IvanIkra/tablo-t75/cad/preview/back.png

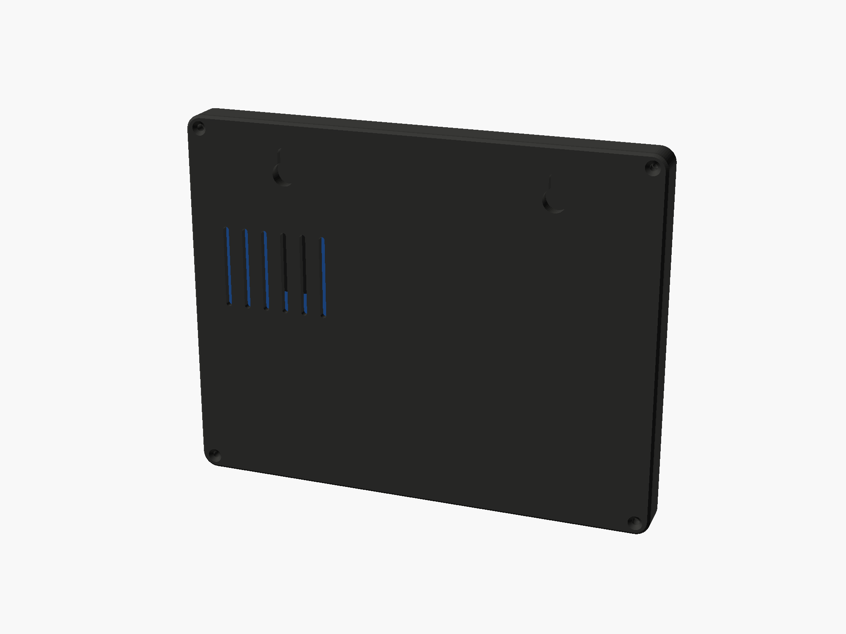
cad/preview/back.png
