IvanIkra/tablo-t75/cad/preview/corner.png

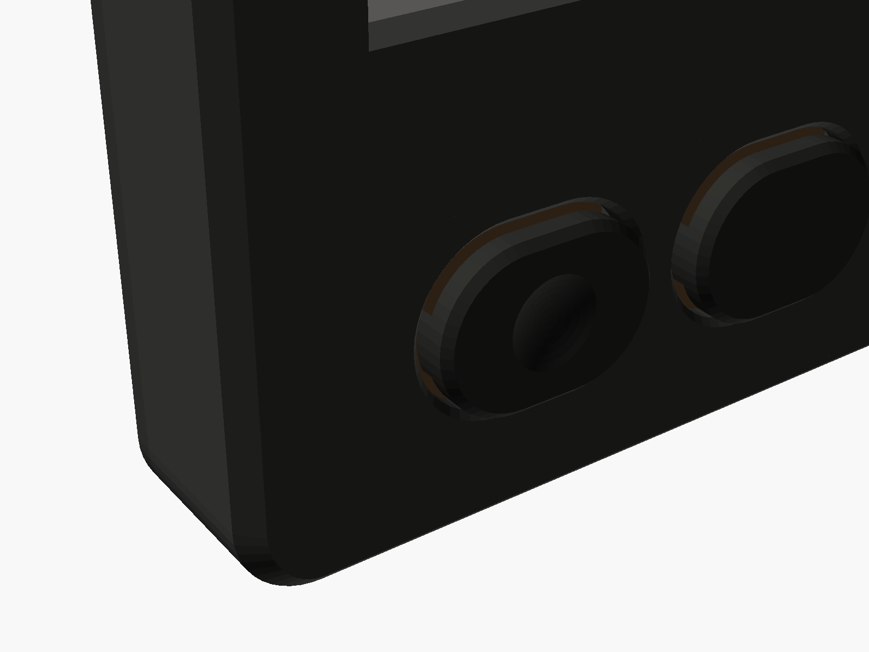
cad/preview/corner.png
