IvanIkra/tablo-t75/cad/preview/desk.png

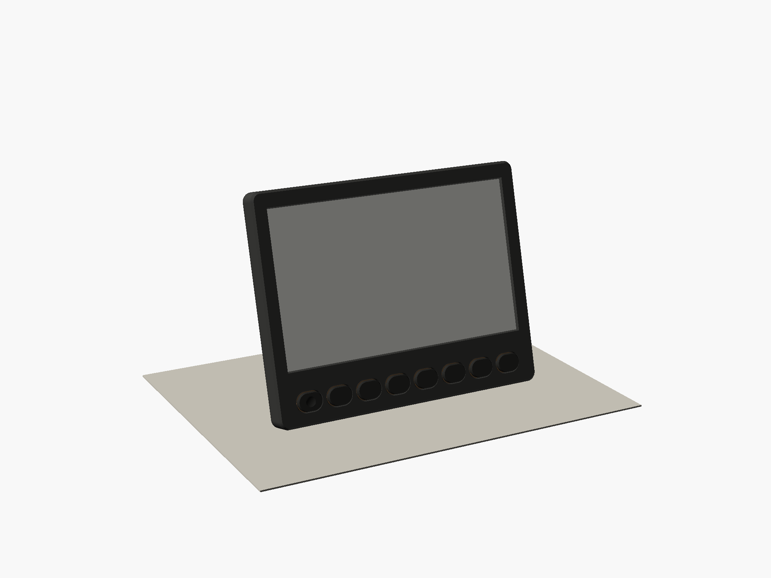
cad/preview/desk.png
