IvanIkra/tablo-t75/cad/preview/desk_back.png

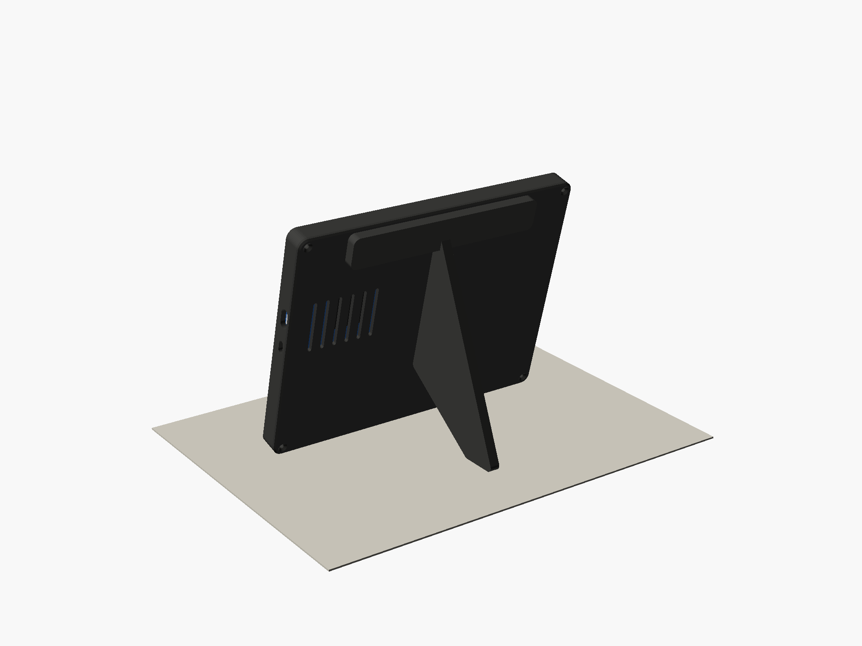
cad/preview/desk_back.png
