IvanIkra/tablo-t75/cad/preview/desk_side.png

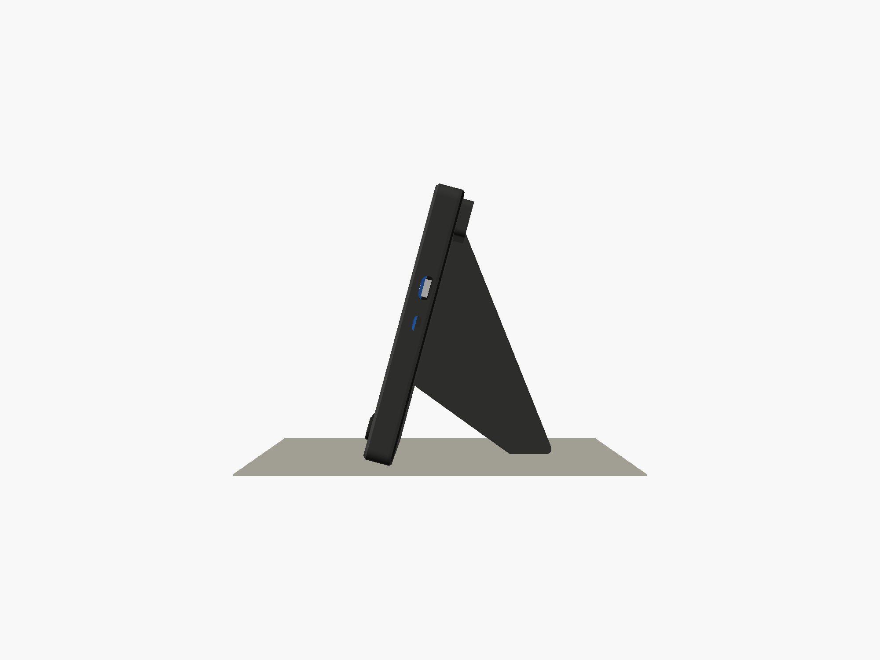
cad/preview/desk_side.png
