IvanIkra/tablo-t75/cad/preview/exploded.png

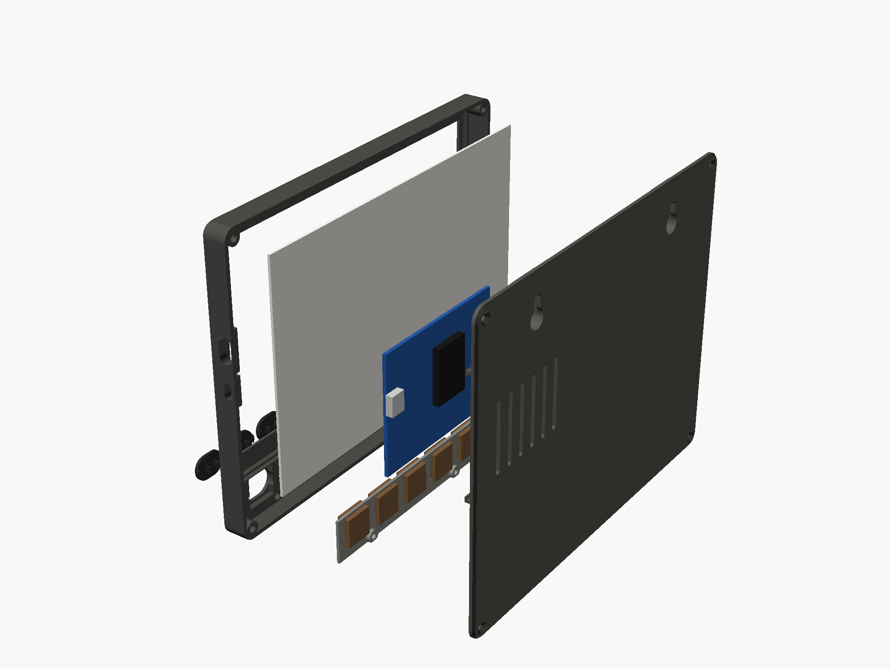
cad/preview/exploded.png
