IvanIkra/tablo-t75/cad/preview/inside.png

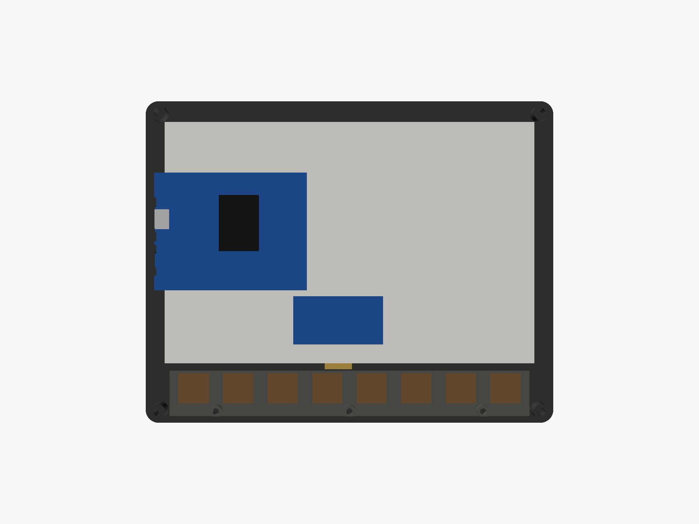
cad/preview/inside.png
