IvanIkra/tablo-t75/cad/preview/leg.png

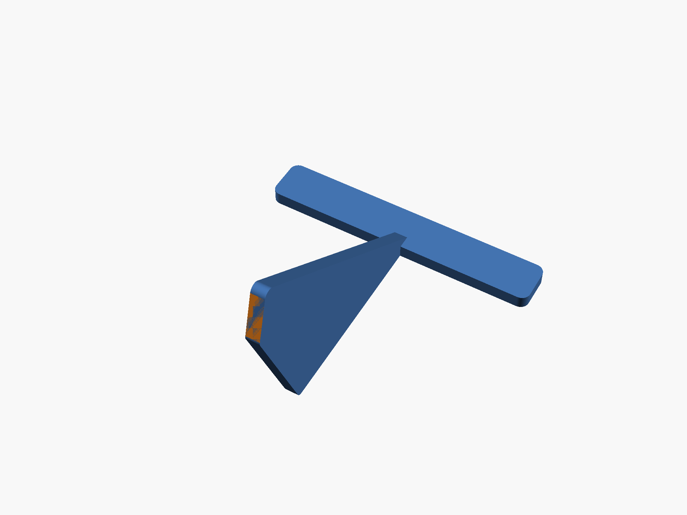
cad/preview/leg.png
