IvanIkra/tablo-t75/cad/preview/ports.png

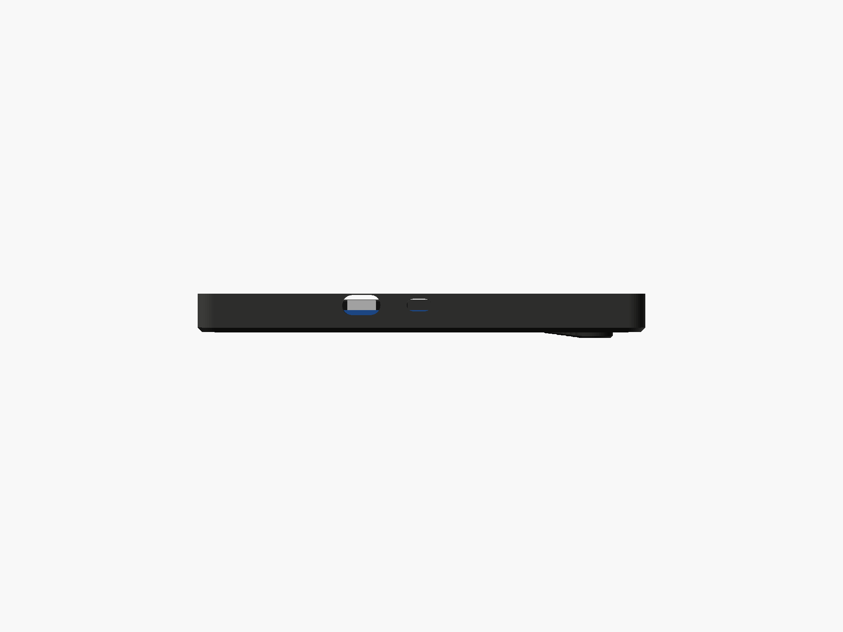
cad/preview/ports.png
