IvanIkra/tablo-t75/cad/preview/wall.png

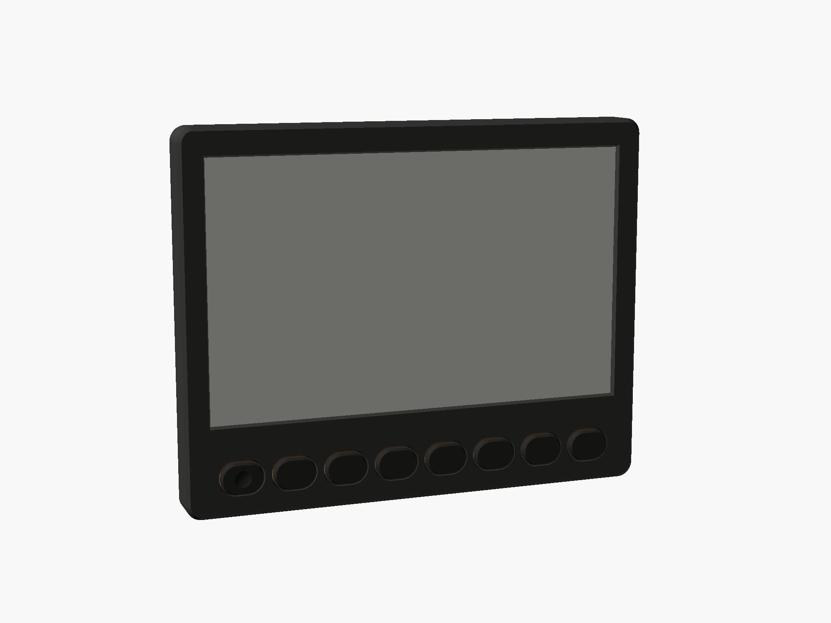
cad/preview/wall.png
