IvanIkra/tablo-t75/cad/preview/wall_mount.png

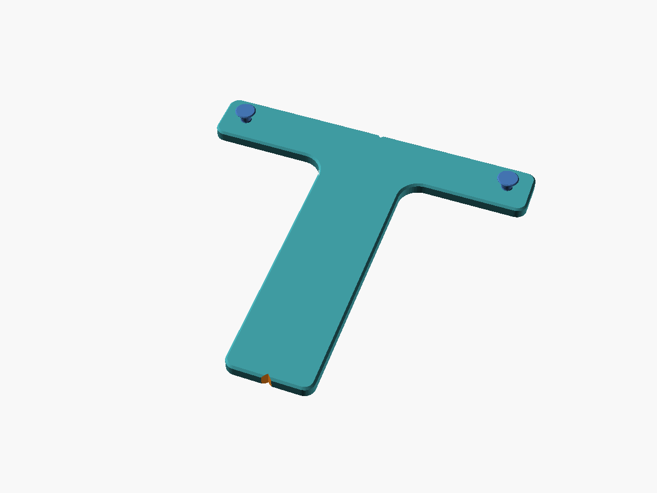
cad/preview/wall_mount.png
