IvanIkra/tablo-t75/cad/preview/wall_mount_back.png

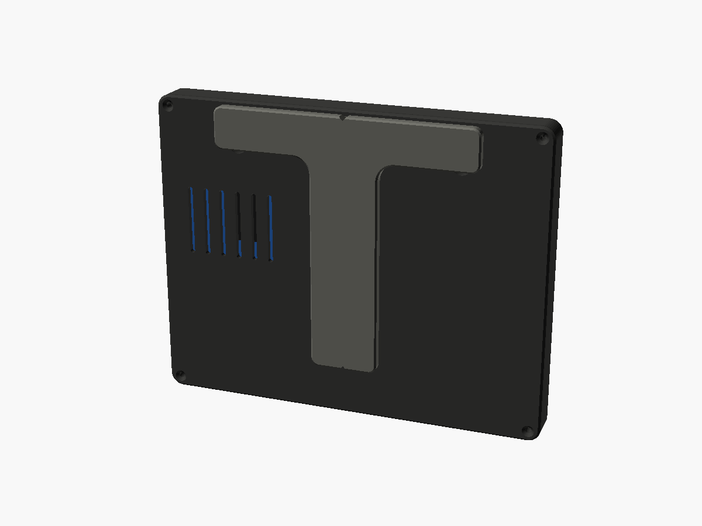
cad/preview/wall_mount_back.png
