IvanIkra/tablo-t75/docs/images/social-preview.png

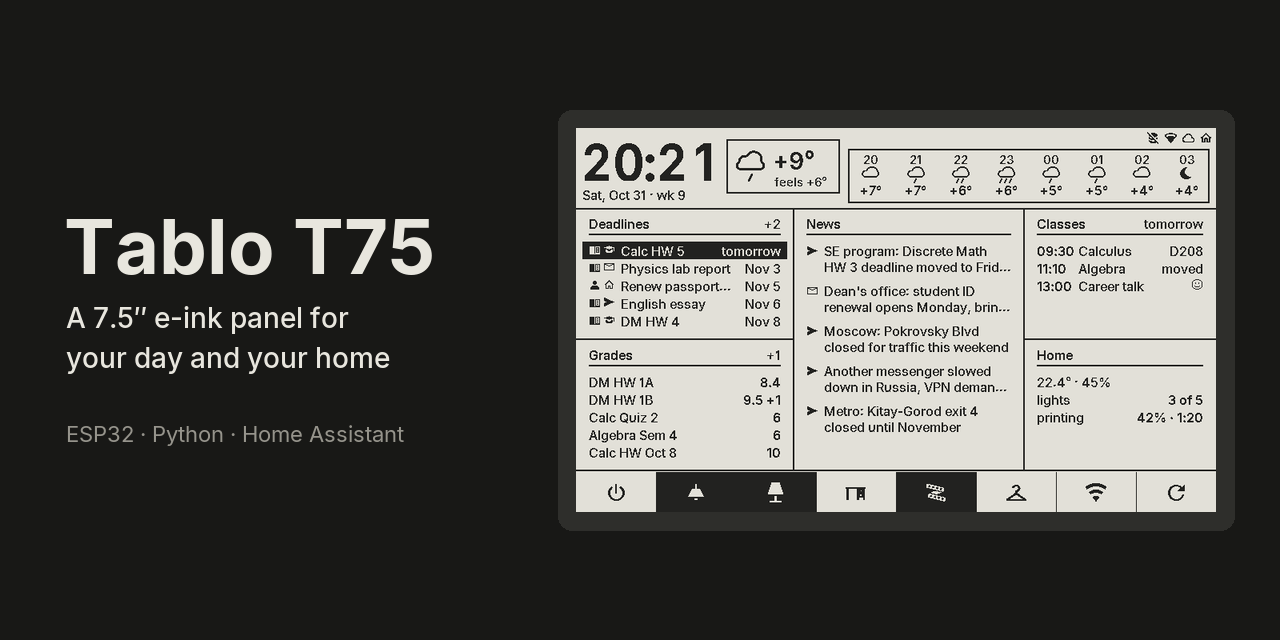
docs/images/social-preview.png
