IvanIkra/tablo-t75/presentation/r3/tablo-back-en.png

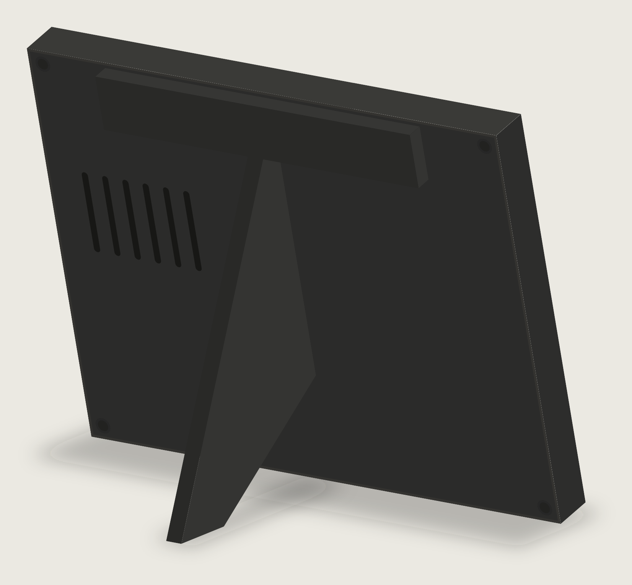
presentation/r3/tablo-back-en.png
