IvanIkra/tablo-t75/presentation/r3/tablo-body-en.png

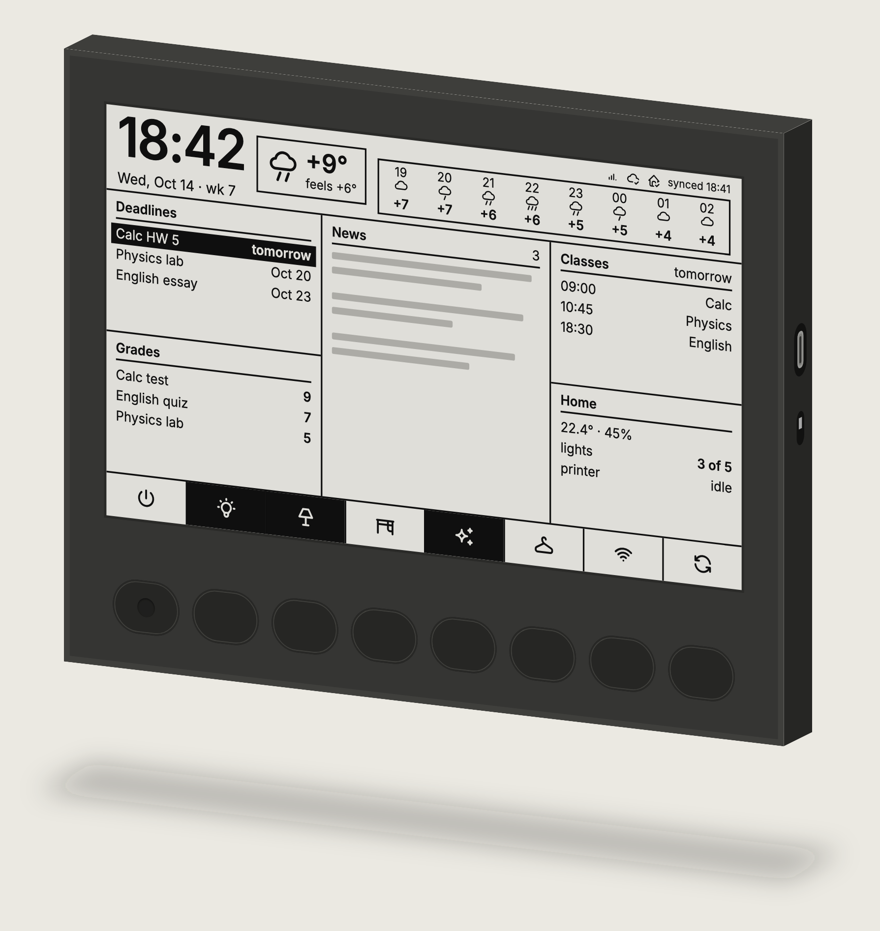
presentation/r3/tablo-body-en.png
