IvanIkra/tablo-t75/presentation/r3/tablo-sheet-en.png

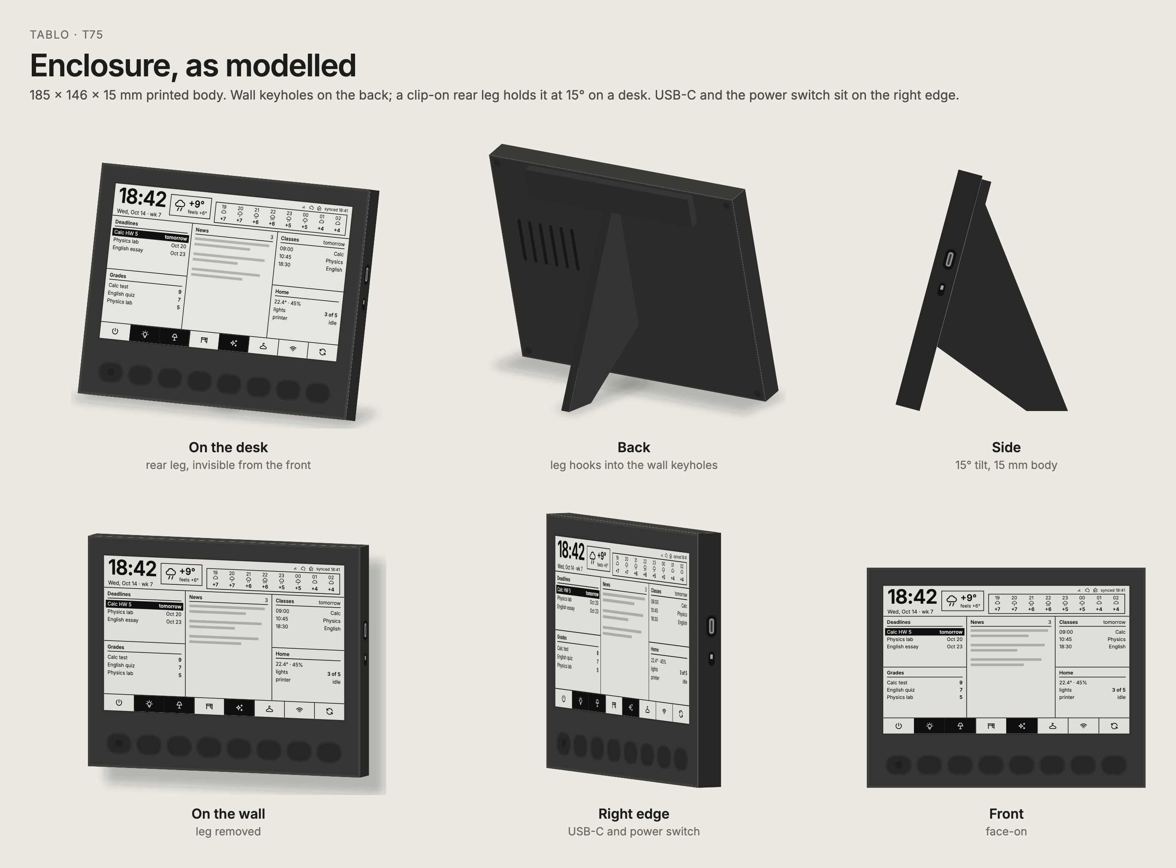
presentation/r3/tablo-sheet-en.png
