IvanIkra/tablo-t75/presentation/r3/tablo-wall-en.png

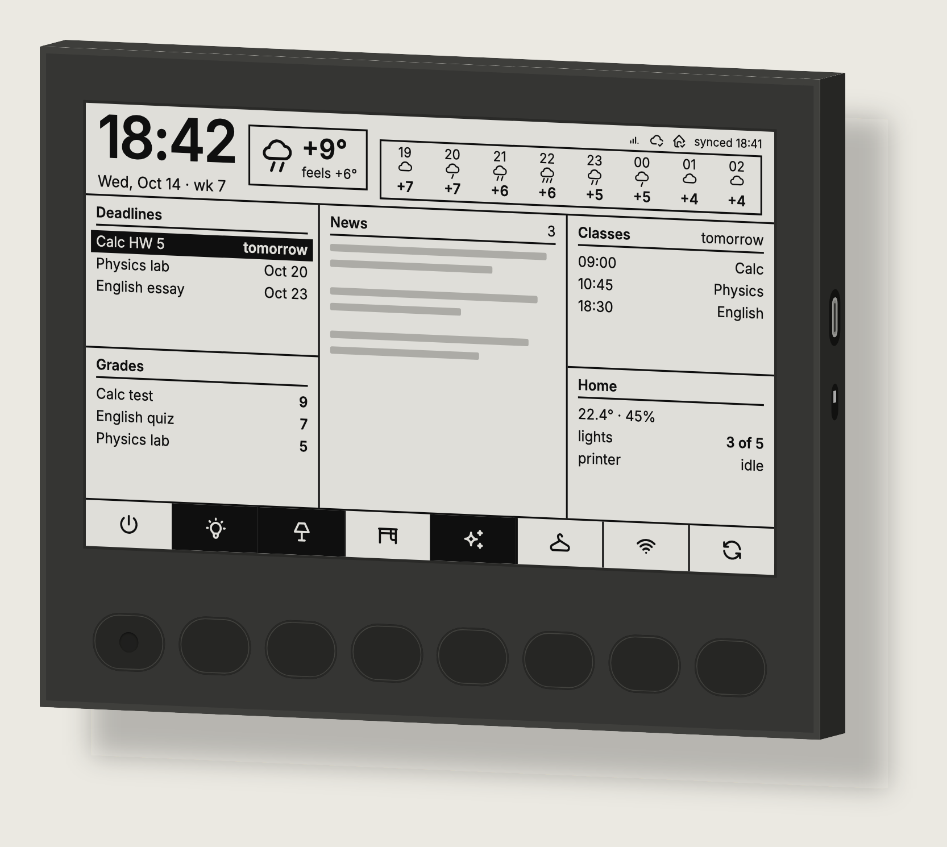
presentation/r3/tablo-wall-en.png
