IvanIkra/tablo-t75/pcb/bom-parts.csv

Value | Footprint | Fit | Manufacturer | MPN | Description | Notes
10u | Capacitor_SMD:C_0805_2012Metric | yes | Samsung | CL21A106KAYNNNE | Ceramic capacitor 10 uF 25 V X5R 0805 | any 10 uF ≥16 V X5R/X7R 0805
100n | Capacitor_SMD:C_0402_1005Metric | yes | Samsung | CL05B104KO5NNNC | Ceramic capacitor 100 nF 16 V X7R 0402 | any equivalent
22u | Capacitor_SMD:C_0805_2012Metric | yes | Samsung | CL21A226MQQNNNE | Ceramic capacitor 22 uF 6.3 V X5R 0805 | any 22 uF ≥6.3 V X5R 0805
1u | Capacitor_SMD:C_0603_1608Metric | yes | Samsung | CL10A105KB8NNNC | Ceramic capacitor 1 uF 50 V X5R 0603 | any 1 uF ≥16 V 0603
12p | Capacitor_SMD:C_0402_1005Metric | yes | Murata | GRM1555C1H120JA01D | Ceramic capacitor 12 pF 50 V C0G 0402 | C0G/NP0 only
4.7u 25V | Capacitor_SMD:C_0805_2012Metric | yes | Samsung | CL21A475KAQNNNE | Ceramic capacitor 4.7 uF 25 V X5R 0805 | ≥25 V rating required (e-paper booster)
1u 25V | Capacitor_SMD:C_0603_1608Metric | yes | Samsung | CL10A105KB8NNNC | Ceramic capacitor 1 uF 50 V X5R 0603 | ≥25 V rating required
MBR0530 | Diode_SMD:D_SOD-123 | yes | onsemi | MBR0530T1G | Schottky diode 30 V 0.5 A SOD-123
USB-C | Connector_USB:USB_C_Receptacle_HRO_TYPE-C-31-M-12 | yes | Korean Hroparts | TYPE-C-31-M-12 | USB Type-C receptacle 16 pin, SMD with through-hole shell pegs
LiPo 604060 | Connector_Wire:SolderWire-0.25sqmm_1x02_P4.2mm_D0.65mm_OD1.7mm | no |  |  | Battery lead pads | do not fit: the battery leads are soldered by hand
GDEY075T7 FPC | Connector_FFC-FPC:Hirose_FH12-24S-0.5SH_1x24-1MP_P0.50mm_Horizontal | yes | Hirose | FH12A-24S-0.5SH(55) | FPC connector 24 pin 0.5 mm, horizontal, TOP contact, flip lock | top contact is required: the screen FPC reaches the connector with its contacts facing up; same land pattern as FH12 (Hirose catalog)
0.47u | Inductor_SMD:L_Taiyo-Yuden_NR-40xx | yes | Coilcraft | XFL4015-471MEC | Power inductor 0.47 uH, Isat ≥ 4 A, 4 x 4 mm | TPS63802 datasheet choice (Isat 5.4 A at 20 % drop); its terminals sit inside the 4 x 4 mm land on the board
10u 1A | Inductor_SMD:L_Taiyo-Yuden_NR-40xx | yes | Sunlord | SWPA4018S100MT | Power inductor 10 uH, Isat 1.3 A, Irms 0.84 A, 4 x 4 x 1.8 mm | land 1.1 x 3.7 mm pads, 1.9 mm gap: fits the NR-40xx land; Taiyo Yuden NR4018T100M is the same but not for new designs
Si1308EDL | Package_TO_SOT_SMD:SOT-323_SC-70 | yes | Vishay | Si1308EDL-T1-GE3 | N-channel MOSFET 30 V SC-70
5.1k | Resistor_SMD:R_0402_1005Metric | yes | Yageo | RC0402FR-075K1L | Resistor 5.1 kOhm 1% 0402
1.0k | Resistor_SMD:R_0402_1005Metric | yes | Yageo | RC0402FR-071KL | Resistor 1 kOhm 1% 0402 | sets the charge current
1.1k | Resistor_SMD:R_0402_1005Metric | yes | Yageo | RC0402FR-071K1L | Resistor 1.1 kOhm 1% 0402 | sets the input current limit
10k | Resistor_SMD:R_0402_1005Metric | yes | Yageo | RC0402FR-0710KL | Resistor 10 kOhm 1% 0402
100k | Resistor_SMD:R_0402_1005Metric | yes | Yageo | RC0402FR-07100KL | Resistor 100 kOhm 1% 0402
4.7k | Resistor_SMD:R_0402_1005Metric | yes | Yageo | RC0402FR-074K7L | Resistor 4.7 kOhm 1% 0402
511k | Resistor_SMD:R_0402_1005Metric | yes | Yageo | RC0402FR-07511KL | Resistor 511 kOhm 1% 0402 | regulator feedback: 1% required
91k | Resistor_SMD:R_0402_1005Metric | yes | Yageo | RC0402FR-0791KL | Resistor 91 kOhm 1% 0402 | regulator feedback: 1% required
1M | Resistor_SMD:R_0402_1005Metric | yes | Yageo | RC0402FR-071ML | Resistor 1 MOhm 1% 0402
0.47 | Resistor_SMD:R_0603_1608Metric | yes | Yageo | RL0603FR-070R47L | Current sense resistor 0.47 Ohm 1% 0603
Choc K1 | tablo:Kailh_Choc_V1 | no | Kailh | CPG1350 | Kailh Choc v1 low-profile switch | do not fit: soldered by hand after the switches are clipped into the enclosure plate
Choc K2 | tablo:Kailh_Choc_V1 | no | Kailh | CPG1350 | Kailh Choc v1 low-profile switch | do not fit: soldered by hand after the switches are clipped into the enclosure plate
Choc K3 | tablo:Kailh_Choc_V1 | no | Kailh | CPG1350 | Kailh Choc v1 low-profile switch | do not fit: soldered by hand after the switches are clipped into the enclosure plate
Choc K4 | tablo:Kailh_Choc_V1 | no | Kailh | CPG1350 | Kailh Choc v1 low-profile switch | do not fit: soldered by hand after the switches are clipped into the enclosure plate
Choc K5 | tablo:Kailh_Choc_V1 | no | Kailh | CPG1350 | Kailh Choc v1 low-profile switch | do not fit: soldered by hand after the switches are clipped into the enclosure plate
Choc K6 | tablo:Kailh_Choc_V1 | no | Kailh | CPG1350 | Kailh Choc v1 low-profile switch | do not fit: soldered by hand after the switches are clipped into the enclosure plate
Choc K7 | tablo:Kailh_Choc_V1 | no | Kailh | CPG1350 | Kailh Choc v1 low-profile switch | do not fit: soldered by hand after the switches are clipped into the enclosure plate
Choc K8 | tablo:Kailh_Choc_V1 | no | Kailh | CPG1350 | Kailh Choc v1 low-profile switch | do not fit: soldered by hand after the switches are clipped into the enclosure plate
RESET | Button_Switch_SMD:SW_Push_1P1T_XKB_TS-1187A | yes | XKB Connection | TS-1187A-B-A-B | Tactile switch SMD 5.1 x 5.1 mm
BOOT | Button_Switch_SMD:SW_Push_1P1T_XKB_TS-1187A | yes | XKB Connection | TS-1187A-B-A-B | Tactile switch SMD 5.1 x 5.1 mm
Power | Button_Switch_SMD:SW_SPDT_PCM12 | yes | C&K | PCM12SMTR | Slide switch SPDT SMD, right angle
+3V3 | TestPoint:TestPoint_Pad_D1.0mm | no |  |  | Test pad | copper only
GND | TestPoint:TestPoint_Pad_D1.0mm | no |  |  | Test pad | copper only
VBAT | TestPoint:TestPoint_Pad_D1.0mm | no |  |  | Test pad | copper only
VSYS | TestPoint:TestPoint_Pad_D1.0mm | no |  |  | Test pad | copper only
UART_TX | TestPoint:TestPoint_Pad_D1.0mm | no |  |  | Test pad | copper only
UART_RX | TestPoint:TestPoint_Pad_D1.0mm | no |  |  | Test pad | copper only
ESP32-S3-WROOM-1U-N16R8 | RF_Module:ESP32-S3-WROOM-1U | yes | Espressif | ESP32-S3-WROOM-1U-N16R8 | Wi-Fi/BLE module, 16 MB flash, 8 MB PSRAM, U.FL antenna connector
BQ24074RGT | Package_DFN_QFN:VQFN-16-1EP_3x3mm_P0.5mm_EP1.6x1.6mm | yes | Texas Instruments | BQ24074RGTR | Li-ion charger with power path, VQFN-16 3 x 3 mm | exposed pad must be soldered
MAX17048G+T10 | Package_DFN_QFN:TDFN-8-1EP_2x2mm_P0.5mm_EP0.8x1.2mm | yes | Analog Devices | MAX17048G+T10 | Li-ion fuel gauge, TDFN-8 2 x 2 mm | exposed pad must be soldered
TPS63802DLAR | tablo:Texas_DLA0010A_VSON-HR-10_2x3mm | yes | Texas Instruments | TPS63802DLAR | Buck-boost converter 3.3 V, VSON-HR-10 2 x 3 mm | land pattern from the datasheet (DLA0010A)
TPS22917DBV | Package_TO_SOT_SMD:SOT-23-6 | yes | Texas Instruments | TPS22917DBVR | Load switch 2 A, SOT-23-6
USBLC6-2SC6 | Package_TO_SOT_SMD:SOT-23-6 | yes | STMicroelectronics | USBLC6-2SC6 | USB ESD protection, SOT-23-6
32.768k | Crystal:Crystal_SMD_3215-2Pin_3.2x1.5mm | yes | Epson | Q13FC13500003 | Crystal FC-135 32.768 kHz, 9 pF load, ±20 ppm, 3.2 x 1.5 mm | 9 pF load matches the 12 pF caps on each side
