IvanIkra/tablo-t75/cad/stl/custom/tablo-wall_mount.stl

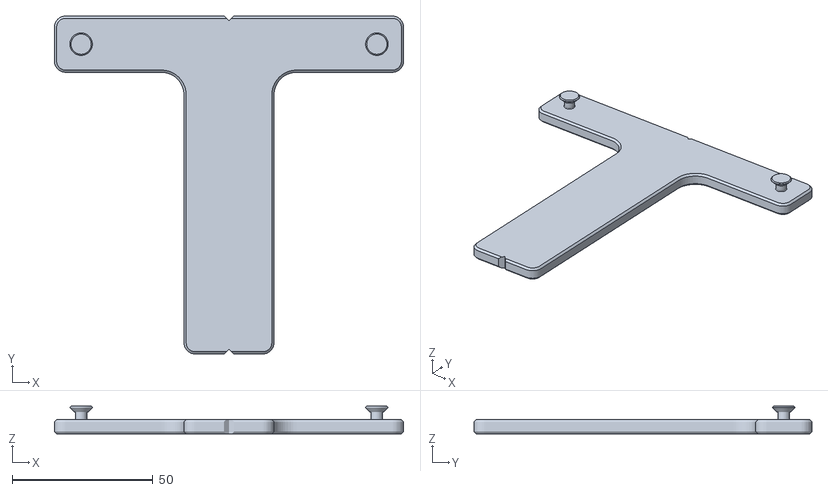
[picture p42: CAD file, 2026-11-09]
cad/stl/custom/tablo-wall_mount.stl
124.0 x 120.0 x 9.79
