IvanIkra/tablo-t75/cad/stl/custom/tablo-front.stl

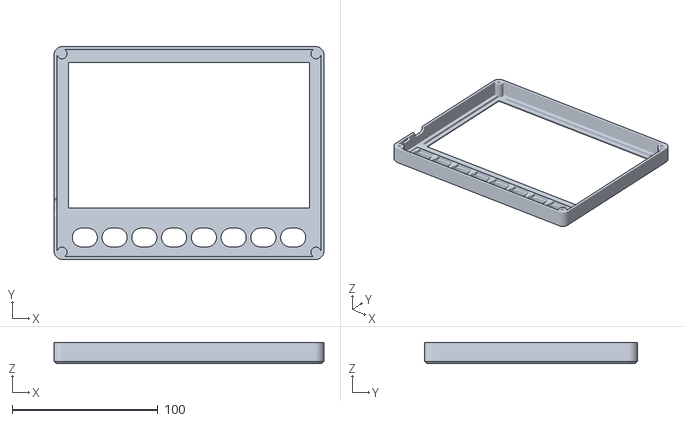
[picture p43: CAD file, 2026-11-09]
cad/stl/custom/tablo-front.stl
185.0 x 146.0 x 14.5
