IvanIkra/tablo-t75/cad/stl/esp32l/tablo-peg.stl

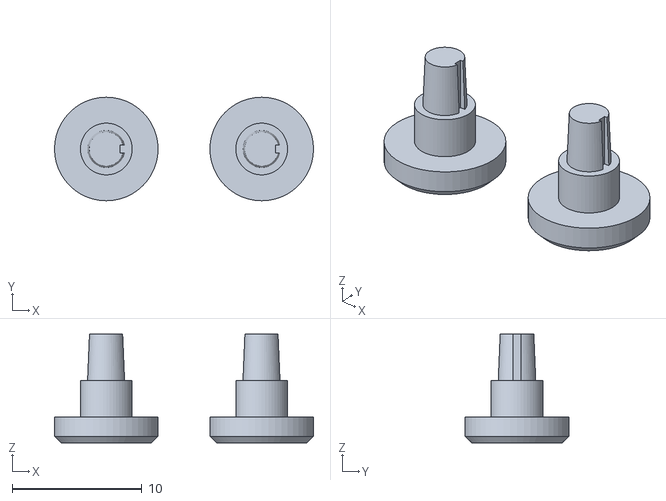
[picture p44: CAD file, 2026-10-31]
cad/stl/esp32l/tablo-peg.stl
20.0 x 8.00 x 8.39
