IvanIkra/tablo-t75/cad/stl/custom/tablo-key_test.stl

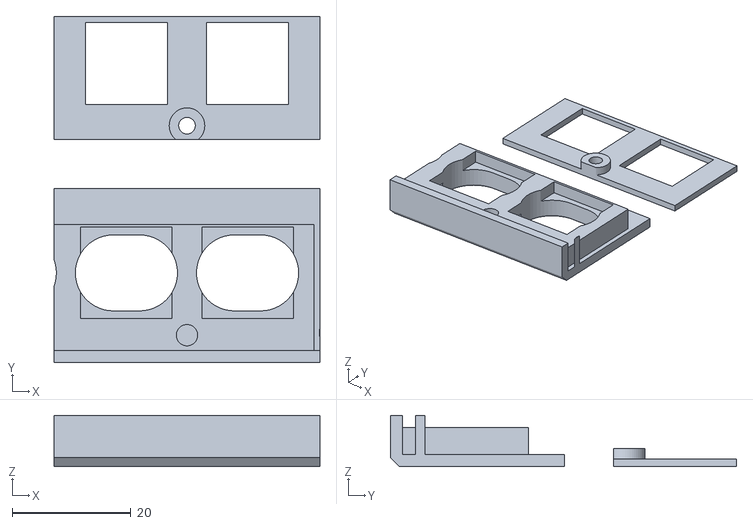
[picture p45: CAD file, 2026-11-09]
cad/stl/custom/tablo-key_test.stl
44.8 x 58.3 x 8.60
