IvanIkra/tablo-t75/cad/stl/esp32l/tablo-back.stl

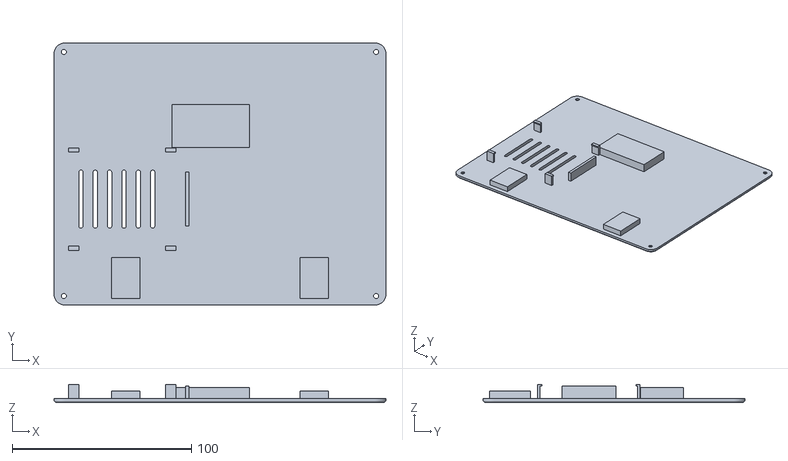
[picture p46: CAD file, 2026-10-30]
cad/stl/esp32l/tablo-back.stl
185.0 x 146.0 x 10.3
