IvanIkra/tablo-t75/cad/stl/custom/tablo-back.stl

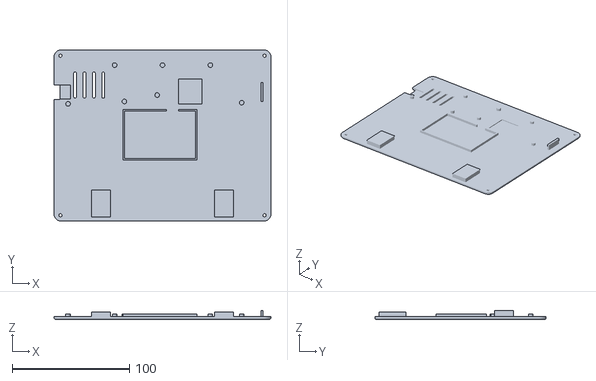
[picture p47: CAD file, 2026-11-09]
cad/stl/custom/tablo-back.stl
185.0 x 146.0 x 7.90
