IvanIkra/tablo-t75/cad/stl/custom/tablo-leg.stl

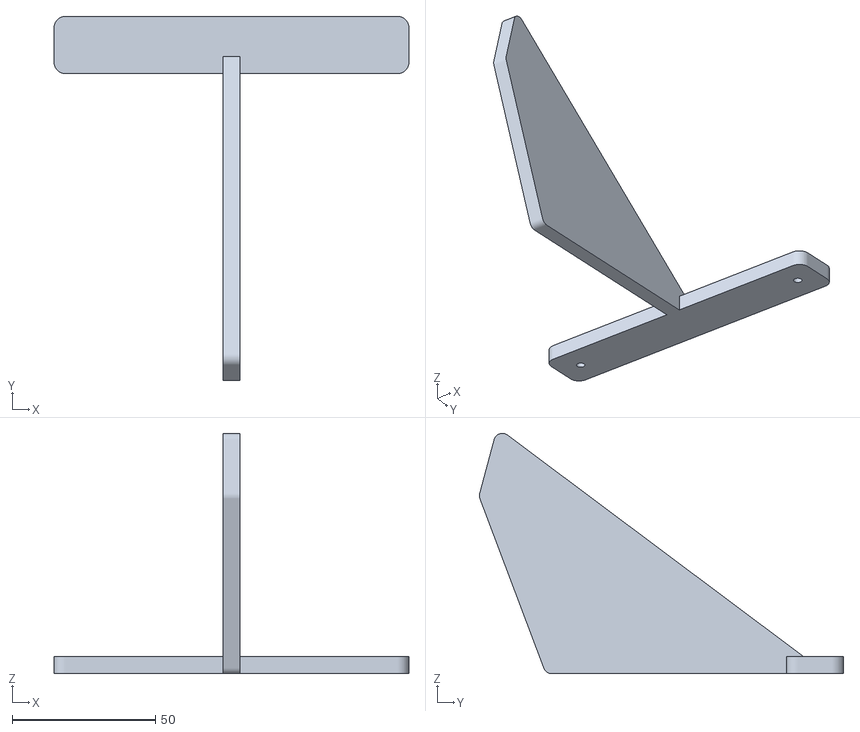
[picture p48: CAD file, 2026-10-17]
cad/stl/custom/tablo-leg.stl
124.0 x 127.2 x 83.9
