IvanIkra/tablo-t75/cad/stl/esp32l/tablo-keycap_dimple.stl

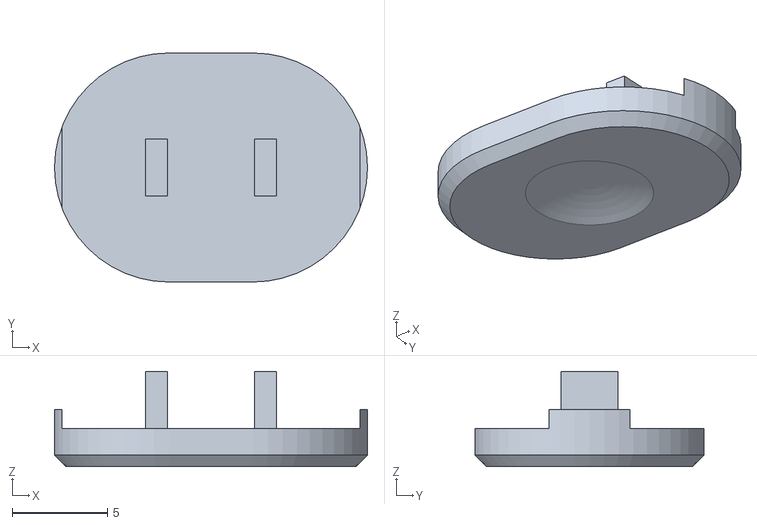
[picture p49: CAD file, 2026-10-17]
cad/stl/esp32l/tablo-keycap_dimple.stl
16.4 x 12.0 x 4.99
