IvanIkra/tablo-t75/cad/stl/custom/tablo-keycap.stl

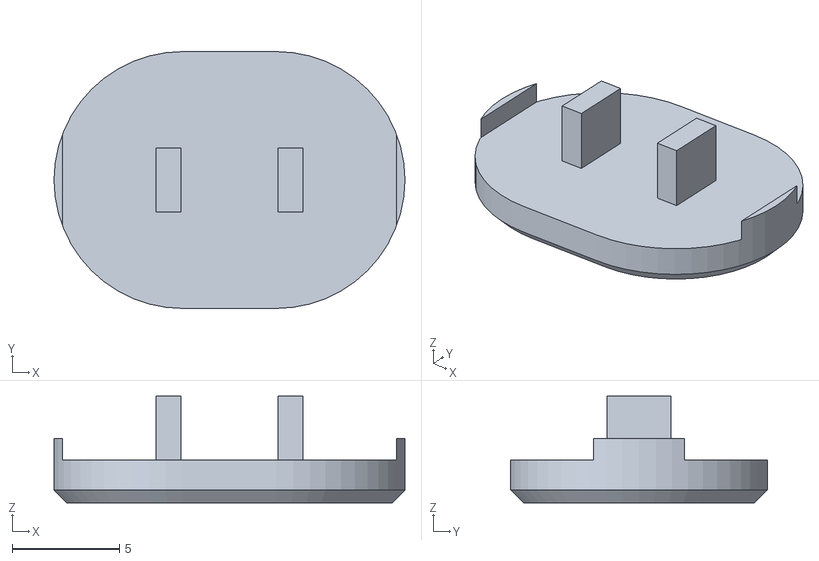
[picture p50: CAD file, 2026-10-17]
cad/stl/custom/tablo-keycap.stl
16.4 x 12.0 x 4.99
