IvanIkra/tablo-t75/cad/stl/esp32l/tablo-key_plate.stl

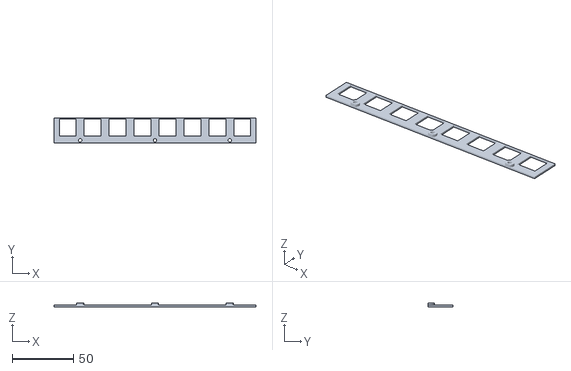
[picture p51: CAD file, 2026-10-17]
cad/stl/esp32l/tablo-key_plate.stl
165.2 x 20.7 x 3.00
