IvanIkra/tablo-t75/(list of files, cad)

Other CAD files:
cad/stl/esp32l/tablo-wall_mount.stl
cad/stl/esp32l/tablo-front.stl
cad/stl/esp32l/tablo-key_test.stl
