IvanIkra/tablo-t75/cad/preview/key_test.png

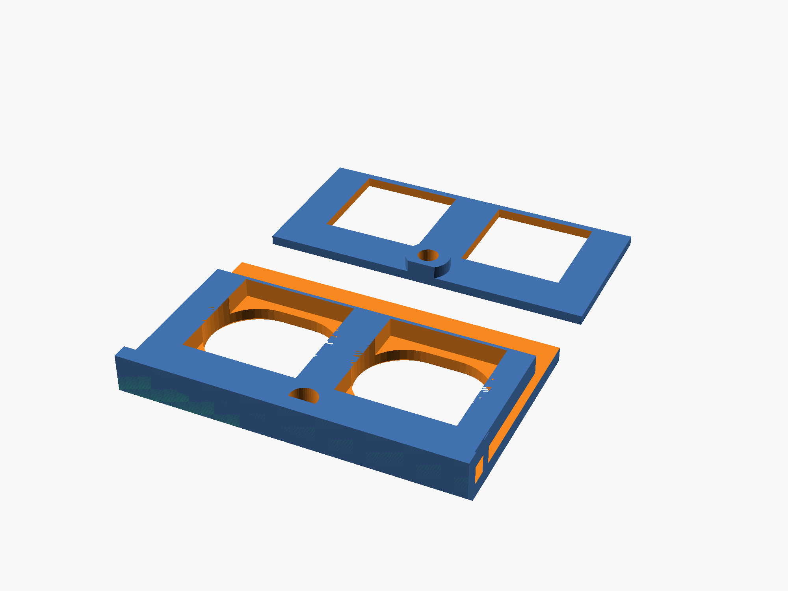
cad/preview/key_test.png
