IvanIkra/tablo-t75/pcb/tablo.kicad_pcb

## KiCad design pcb/tablo.kicad_pcb (2026-11-09)

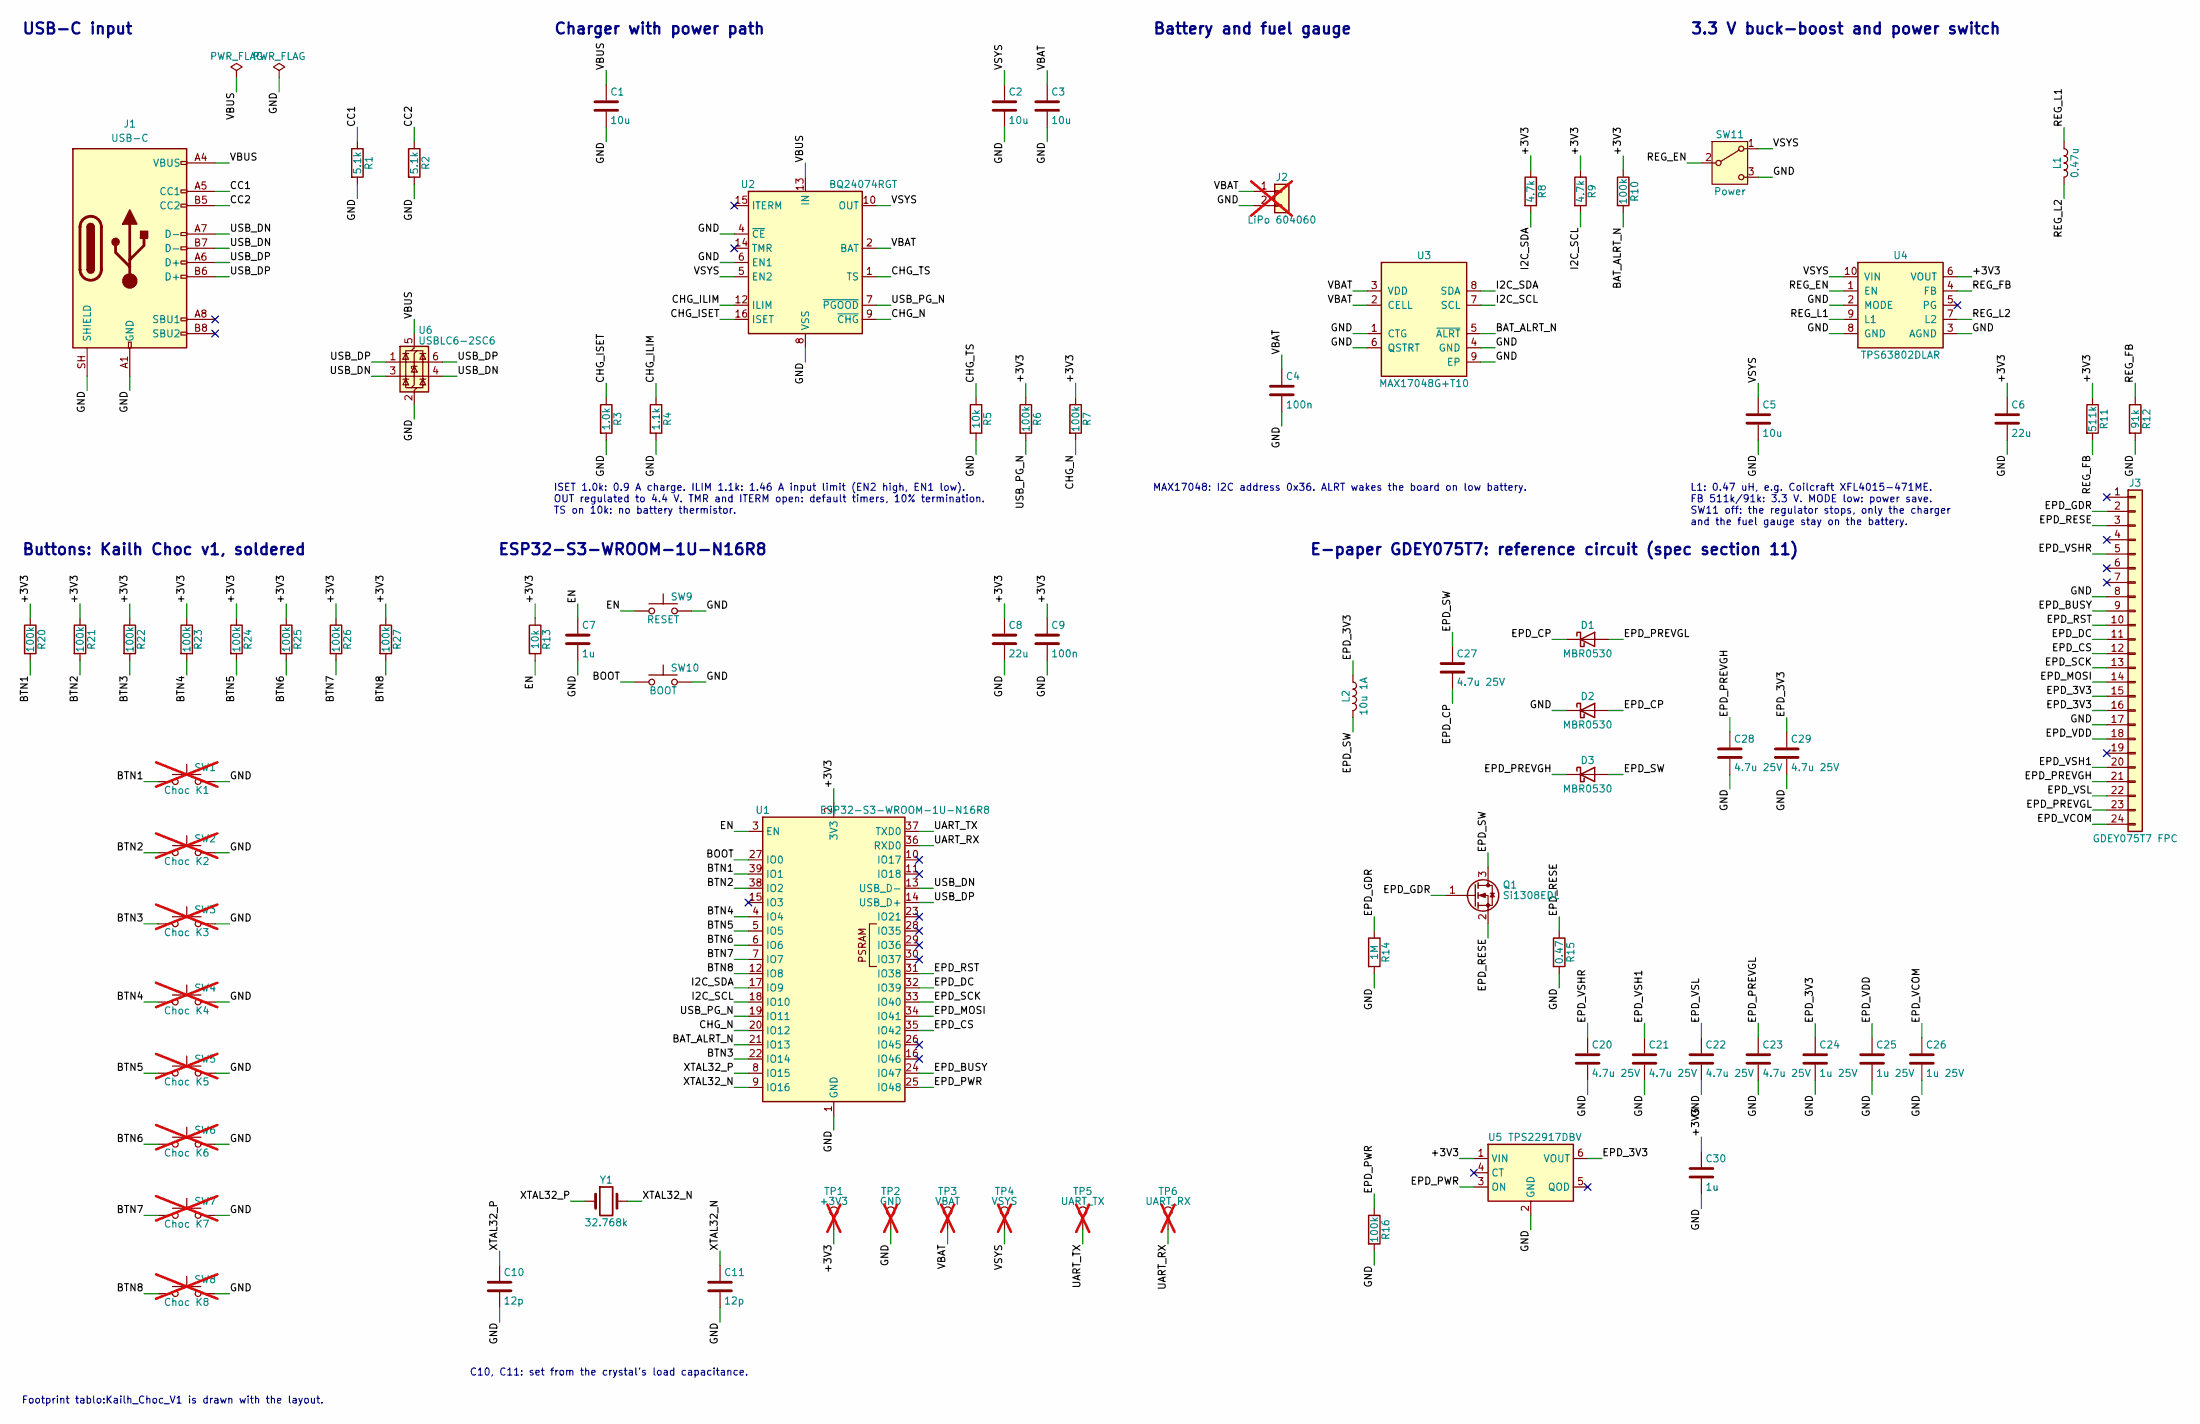
[picture p53: schematic tablo.kicad_sch, Tablo T75 main board]

Parts:
C1, C2, C3, C5: 10u; C_0805_2012Metric
C4, C9: 100n; C_0402_1005Metric
C6, C8: 22u; C_0805_2012Metric
C7, C30: 1u; C_0603_1608Metric
C10, C11: 12p; C_0402_1005Metric
C20, C21, C22, C23, C27, C28, C29: 4.7u 25V; C_0805_2012Metric
C24, C25, C26: 1u 25V; C_0603_1608Metric
D1, D2, D3: MBR0530; D_SOD-123
J1: USB-C; USB_C_Receptacle_HRO_TYPE-C-31-M-12
J2: LiPo 604060; SolderWire-0.25sqmm_1x02_P4.2mm_D0.65mm_OD1.7mm; not fitted
J3: GDEY075T7 FPC; Hirose_FH12-24S-0.5SH_1x24-1MP_P0.50mm_Horizontal
L1: 0.47u; L_Taiyo-Yuden_NR-40xx
L2: 10u 1A; L_Taiyo-Yuden_NR-40xx
Q1: Si1308EDL; SOT-323_SC-70
R1, R2: 5.1k; R_0402_1005Metric
R3: 1.0k; R_0402_1005Metric
R4: 1.1k; R_0402_1005Metric
R5, R13: 10k; R_0402_1005Metric
R6, R7, R10, R16, R20, R21, R22, R23, R24, R25, R26, R27: 100k; R_0402_1005Metric
R8, R9: 4.7k; R_0402_1005Metric
R11: 511k; R_0402_1005Metric
R12: 91k; R_0402_1005Metric
R14: 1M; R_0402_1005Metric
R15: 0.47; R_0603_1608Metric
SW1: Choc K1; Kailh_Choc_V1; not fitted
SW2: Choc K2; Kailh_Choc_V1; not fitted
SW3: Choc K3; Kailh_Choc_V1; not fitted
SW4: Choc K4; Kailh_Choc_V1; not fitted
SW5: Choc K5; Kailh_Choc_V1; not fitted
SW6: Choc K6; Kailh_Choc_V1; not fitted
SW7: Choc K7; Kailh_Choc_V1; not fitted
SW8: Choc K8; Kailh_Choc_V1; not fitted
SW9: RESET; SW_Push_1P1T_XKB_TS-1187A
SW10: BOOT; SW_Push_1P1T_XKB_TS-1187A
SW11: Power; SW_SPDT_PCM12
TP1: +3V3; TestPoint_Pad_D1.0mm; not fitted
TP2: GND; TestPoint_Pad_D1.0mm; not fitted
TP3: VBAT; TestPoint_Pad_D1.0mm; not fitted
TP4: VSYS; TestPoint_Pad_D1.0mm; not fitted
TP5: UART_TX; TestPoint_Pad_D1.0mm; not fitted
TP6: UART_RX; TestPoint_Pad_D1.0mm; not fitted
U1: ESP32-S3-WROOM-1U-N16R8; ESP32-S3-WROOM-1U
U2: BQ24074RGT; VQFN-16-1EP_3x3mm_P0.5mm_EP1.6x1.6mm
U3: MAX17048G+T10; TDFN-8-1EP_2x2mm_P0.5mm_EP0.8x1.2mm
U4: TPS63802DLAR; Texas_DLA0010A_VSON-HR-10_2x3mm
U5: TPS22917DBV; SOT-23-6
U6: USBLC6-2SC6; SOT-23-6
Y1: 32.768k; Crystal_SMD_3215-2Pin_3.2x1.5mm

Connections:
/+3V3: C6.1, C8.1, C9.1, C30.1, R6.1, R7.1, R8.1, R9.1, R10.1, R11.1, R13.1, R20.1, R21.1, R22.1, R23.1, R24.1, R25.1, R26.1, R27.1, TP1.1, U1.2 (3V3), U4.6 (VOUT), U5.1 (VIN)
/BAT_ALRT_N: R10.2, U1.21 (IO13), U3.5 (~ALRT)
/BOOT: SW10.1, U1.27 (IO0)
/BTN1: R20.2, SW1.1, U1.39 (IO1)
/BTN2: R21.2, SW2.1, U1.38 (IO2)
/BTN3: R22.2, SW3.1, U1.22 (IO14)
/BTN4: R23.2, SW4.1, U1.4 (IO4)
/BTN5: R24.2, SW5.1, U1.5 (IO5)
/BTN6: R25.2, SW6.1, U1.6 (IO6)
/BTN7: R26.2, SW7.1, U1.7 (IO7)
/BTN8: R27.2, SW8.1, U1.12 (IO8)
/CC1: J1.A5 (CC1), R1.1
/CC2: J1.B5 (CC2), R2.1
/CHG_ILIM: R4.1, U2.12 (ILIM)
/CHG_ISET: R3.1, U2.16 (ISET)
/CHG_N: R7.2, U1.20 (IO12), U2.9 (~CHG)
/CHG_TS: R5.1, U2.1 (TS)
/EN: C7.1, R13.2, SW9.1, U1.3 (EN)
/EPD_3V3: C24.1, C29.1, J3.15, J3.16, L2.1, U5.6 (VOUT)
/EPD_BUSY: J3.9, U1.24 (IO47)
/EPD_CP: C27.2, D1.1 (K), D2.2 (A)
/EPD_CS: J3.12, U1.35 (IO42)
/EPD_DC: J3.11, U1.32 (IO39)
/EPD_GDR: J3.2, Q1.1 (G), R14.1
/EPD_MOSI: J3.14, U1.34 (IO41)
/EPD_PREVGH: C28.1, D3.1 (K), J3.21
/EPD_PREVGL: C23.1, D1.2 (A), J3.23
/EPD_PWR: R16.1, U1.25 (IO48), U5.3 (ON)
/EPD_RESE: J3.3, Q1.2 (S), R15.1
/EPD_RST: J3.10, U1.31 (IO38)
/EPD_SCK: J3.13, U1.33 (IO40)
/EPD_SW: C27.1, D3.2 (A), L2.2, Q1.3 (D)
/EPD_VCOM: C26.1, J3.24
/EPD_VDD: C25.1, J3.18
/EPD_VSH1: C21.1, J3.20
/EPD_VSHR: C20.1, J3.5
/EPD_VSL: C22.1, J3.22
/GND: C1.2, C2.2, C3.2, C4.2, C5.2, C6.2, C7.2, C8.2, C9.2, C10.2, C11.2, C20.2, C21.2, C22.2, C23.2, C24.2, C25.2, C26.2, C28.2, C29.2, C30.2, D2.1 (K), J1.A1 (GND), J1.A12 (GND), J1.B1 (GND), J1.B12 (GND), J1.SH (SHIELD), J2.2, J3.8, J3.17, R1.2, R2.2, R3.2, R4.2, R5.2, R12.2, R14.2, R15.2, R16.2, SW1.2, SW2.2, SW3.2, SW4.2, SW5.2, SW6.2, SW7.2, SW8.2, SW9.2, SW10.2, SW11.3 (C), TP2.1, U1.1 (GND), U1.40 (GND), U1.41 (GND), U2.4 (~CE), U2.6 (EN1), U2.8 (VSS), U2.17 (VSS), U3.1 (CTG), U3.4 (GND), U3.6 (QSTRT), U3.9 (EP), U4.2 (MODE), U4.3 (AGND), U4.8 (GND), U5.2 (GND), U6.2 (GND)
/I2C_SCL: R9.2, U1.18 (IO10), U3.7 (SCL)
/I2C_SDA: R8.2, U1.17 (IO9), U3.8 (SDA)
/REG_EN: SW11.2 (B), U4.1 (EN)
/REG_FB: R11.2, R12.1, U4.4 (FB)
/REG_L1: L1.1, U4.9 (L1)
/REG_L2: L1.2, U4.7 (L2)
/UART_RX: TP6.1, U1.36 (RXD0)
/UART_TX: TP5.1, U1.37 (TXD0)
/USB_DN: J1.A7 (D-), J1.B7 (D-), U1.13 (USB_D-), U6.3 (I/O2), U6.4 (I/O2)
/USB_DP: J1.A6 (D+), J1.B6 (D+), U1.14 (USB_D+), U6.1 (I/O1), U6.6 (I/O1)
/USB_PG_N: R6.2, U1.19 (IO11), U2.7 (~PGOOD)
/VBAT: C3.1, C4.1, J2.1, TP3.1, U2.2 (BAT), U2.3 (BAT), U3.2 (CELL), U3.3 (VDD)
/VBUS: C1.1, J1.A4 (VBUS), J1.A9 (VBUS), J1.B4 (VBUS), J1.B9 (VBUS), U2.13 (IN), U6.5 (VBUS)
/VSYS: C2.1, C5.1, SW11.1 (A), TP4.1, U2.5 (EN2), U2.10 (OUT), U2.11 (OUT), U4.10 (VIN)
/XTAL32_N: C11.1, U1.9 (IO16), Y1.2
/XTAL32_P: C10.1, U1.8 (IO15), Y1.1

Notes on the sheet:
USB-C input
Charger with power path
ISET 1.0k: 0.9 A charge. ILIM 1.1k: 1.46 A input limit (EN2 high, EN1 low). OUT regulated to 4.4 V. TMR and ITERM open: default timers, 10% termination. TS on 10k: no battery thermistor.
Battery and fuel gauge
MAX17048: I2C address 0x36. ALRT wakes the board on low battery.
3.3 V buck-boost and power switch
L1: 0.47 uH, e.g. Coilcraft XFL4015-471ME. FB 511k/91k: 3.3 V. MODE low: power save. SW11 off: the regulator stops, only the charger and the fuel gauge stay on the battery.
ESP32-S3-WROOM-1U-N16R8
C10, C11: set from the crystal's load capacitance.
Buttons: Kailh Choc v1, soldered
Footprint tablo:Kailh_Choc_V1 is drawn with the layout.
E-paper GDEY075T7: reference circuit (spec section 11)

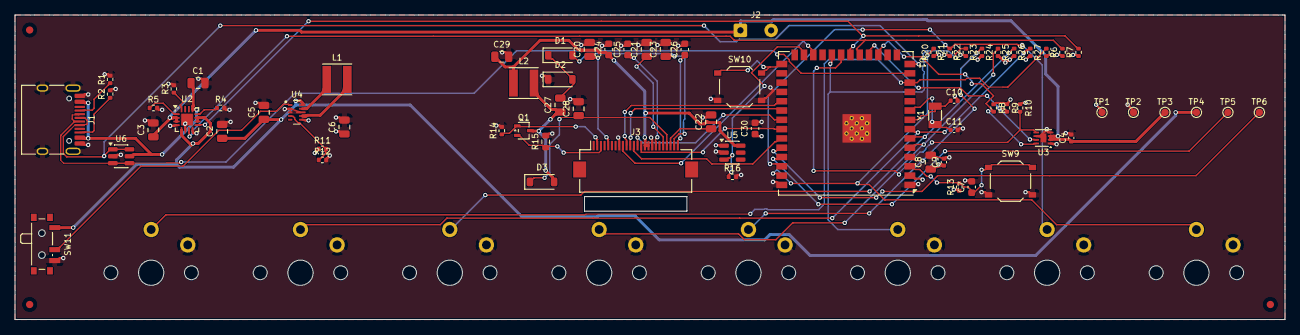
[picture p54: board tablo.kicad_pcb from above]

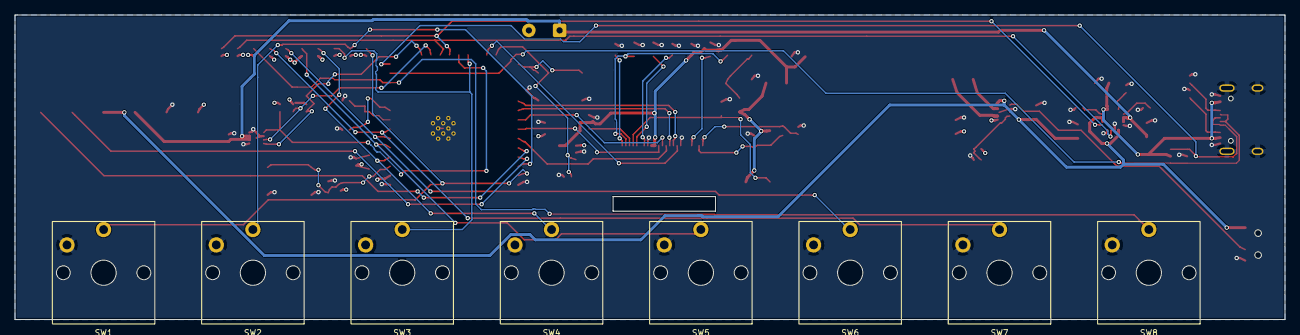
[picture p55: board tablo.kicad_pcb from below]

Board: 4 copper layers, 173.5 x 41.6 mm, 82 parts (8 on the bottom side), 54 nets.

Other parts of the board:
FID1, FID2, FID3: Fiducial_1mm_Mask2mm
