IvanIkra/tablo-t75/firmware/src/zones.cpp

#include "zones.h"

#include <Arduino.h>
#include <WiFi.h>
#include <stdio.h>

#include "assets.h"
#include "screen.h"
#include "state.h"

static const char *WEEKDAYS[] = {"Sun", "Mon", "Tue", "Wed", "Thu", "Fri", "Sat"};
static const char *MONTHS[] = {"Jan", "Feb", "Mar", "Apr", "May", "Jun",
                               "Jul", "Aug", "Sep", "Oct", "Nov", "Dec"};

// Days since 1970-01-01 (Howard Hinnant's days_from_civil).
static long daysFromCivil(int y, int m, int d) {
  y -= m <= 2;
  long era = (y >= 0 ? y : y - 399) / 400;
  long yoe = y - era * 400;
  long doy = (153 * (m + (m > 2 ? -3 : 9)) + 2) / 5 + d - 1;
  long doe = yoe * 365 + yoe / 4 - yoe / 100 + doy;
  return era * 146097 + doe - 719468;
}

// Week 1 is the week (from Monday) of semester_start, as the emulator counts.
static int semesterWeek(const struct tm &t) {
  long today = daysFromCivil(t.tm_year + 1900, t.tm_mon + 1, t.tm_mday);
  long start = daysFromCivil(cfg.semYear, cfg.semMonth, cfg.semDay);
  long weekday = ((start + 4) % 7 + 7) % 7;  // 0 = Sunday; 1970-01-01 was a Thursday
  long monday = start - (weekday + 6) % 7;
  long diff = today - monday;
  return (diff >= 0 ? diff / 7 : (diff - 6) / 7) + 1;
}

void drawClockZone(Canvas &c) {
  c.clear();
  struct tm t;
  if (!localTimeNow(t)) return;  // blank until NTP: no wrong time on the wall
  char hhmm[6];
  snprintf(hhmm, sizeof hhmm, "%02d:%02d", t.tm_hour, t.tm_min);
  // Digits of one width: "HH:MM" is always 174 px and fits the 184 px zone.
  c.text(FONT_CLOCK, 6, 66, hhmm);
  char date[40];
  snprintf(date, sizeof date, "%s, %s %d \xC2\xB7 wk %d", WEEKDAYS[t.tm_wday], MONTHS[t.tm_mon],
           t.tm_mday, semesterWeek(t));
  c.text(FONT_DATE, 8, 90, date);
}

void drawStatusZone(Canvas &c) {
  if (serviceOffline()) {
    c.clear(true);
    char text[32] = "offline";
    struct tm t;
    if (localTimeNow(t)) {
      time_t since = time(nullptr) - (millis() - st.offlineSinceMs) / 1000;
      localtime_r(&since, &t);
      snprintf(text, sizeof text, "offline since %02d:%02d", t.tm_hour, t.tm_min);
    }
    int w = Canvas::textWidth(FONT_SEMI16, text);
    c.text(FONT_SEMI16, c.width() - 8 - w, 17, text, false);
    return;
  }
  // Online: icons only, right to left. The infomaster icon only while its data is old (§3.3).
  c.clear();
  uint32_t icons[4];
  int n = 0;
  icons[n++] = st.connected && health.ha ? ICON_HOME : ICON_HOME_OFF;
  icons[n++] = st.connected ? ICON_CLOUD : ICON_CLOUD_OFF;
  icons[n++] = st.wifiUp ? ICON_WIFI : ICON_WIFI_OFF;
  if (st.connected && !health.data) icons[n++] = ICON_DATA_OFF;
  int x = c.width() - 4;
  for (int i = 0; i < n; i++) {
    const Glyph *g = findGlyph(ICONS, icons[i]);
    if (!g) continue;
    c.glyph(ICONS, x - g->advance, 19, icons[i]);
    x -= g->advance + 5;
  }
}

// Same rows and places as the emulator's: title baseline 48, rows from 84 every 25 px.
Rect diagLine(int i) {
  if (i == 0) return {0, 16, W, DIAG_LINE_MAX_H};
  return {0, (int16_t)(84 - 18 + (i - 1) * 25), W, 24};
}

static void hhmmAgo(char *out, size_t n, uint32_t sinceMs) {
  time_t at = time(nullptr) - (millis() - sinceMs) / 1000;
  struct tm t;
  if (!localTimeNow(t)) {
    snprintf(out, n, "%lu s ago", (unsigned long)((millis() - sinceMs) / 1000));
    return;
  }
  localtime_r(&at, &t);
  snprintf(out, n, "%02d:%02d", t.tm_hour, t.tm_min);
}

void drawDiagLine(Canvas &c, int i) {
  c.clear();
  if (i == 0) {
    c.text(FONT_SEMI30, 40, 32, "Diagnostics");
    return;
  }
  char v[64], at[16];
  const char *k = "";
  uint32_t up = millis() / 1000;
  switch (i) {
    case 1:
      k = "IP";
      snprintf(v, sizeof v, "%s", st.wifiUp ? WiFi.localIP().toString().c_str() : "no Wi-Fi");
      break;
    case 2:
      k = "Wi-Fi";
      if (st.wifiUp) snprintf(v, sizeof v, "%d dBm", WiFi.RSSI());
      else snprintf(v, sizeof v, "down");
      if (st.wifiDrops) {
        size_t n = strlen(v);
        snprintf(v + n, sizeof v - n, " \xC2\xB7 %u drops", st.wifiDrops);
      }
      break;
    case 3:
      k = "Uptime";
      snprintf(v, sizeof v, "%luh %lum %lus", (unsigned long)(up / 3600), (unsigned long)(up / 60 % 60),
               (unsigned long)(up % 60));
      break;
    case 4:
      k = "Firmware";
      snprintf(v, sizeof v, "%s", FW_VERSION);
      break;
    case 5:
      k = "Free heap";
      snprintf(v, sizeof v, "%lu B, largest block %lu B", (unsigned long)heapFree(),
               (unsigned long)heapLargest());
      break;
    case 6:
      k = "Service";
      if (st.connected) {
        snprintf(v, sizeof v, "connected");
      } else {
        hhmmAgo(at, sizeof at, st.offlineSinceMs);
        snprintf(v, sizeof v, "offline since %s", at);
      }
      break;
    case 7:
      k = "Home Assistant";
      snprintf(v, sizeof v, "%s", st.connected ? (health.ha ? "ok" : "down") : "unknown");
      break;
    case 8:
      k = "infomaster";
      snprintf(v, sizeof v, "%s", st.connected ? (health.data ? "ok" : "down \xC2\xB7 saved data") : "unknown");
      break;
    case 9:
      k = "Last frame";
      if (st.lastFrameMs) {
        hhmmAgo(at, sizeof at, st.lastFrameMs);
        snprintf(v, sizeof v, "%s \xC2\xB7 id %lu", at, (unsigned long)st.baseId);
      } else {
        snprintf(v, sizeof v, "none");
      }
      break;
    case 10:
      k = "Last sync";
      snprintf(v, sizeof v, "%s", health.syncedAt[0] ? health.syncedAt : "never");
      break;
    case 11:
      k = "Partial updates";
      snprintf(v, sizeof v, "%u", screen::partialsSinceFull());
      break;
  }
  c.text(FONT_SEMI16, 40, 18, k);
  c.text(FONT_DATE, 230, 18, v);
}

void drawNoticeLine(Canvas &c, int i, const char *text) {
  c.clear();
  if (i == 0) c.text(FONT_SEMI30, 40, 32, text);
  else c.text(FONT_DATE, 40, 18, text);
}
