IvanIkra/tablo-t75/firmware/src/link.h

// WebSocket link to the service (§3.1, §3.3).
#pragma once
#include <stdint.h>

namespace svc {

void begin();  // starts the network task
void loop();   // main loop: handles what the network task received
void overlayClosed(const char *reason);  // "button" / "ttl"
// Firmware update: drop the connection and stop the network task until the restart.
void pause();
// false when the service is not connected: the press did not go anywhere.
bool sendButton(int id, const char *press, uint32_t seq, bool local);

}  // namespace svc
