IvanIkra/tablo-t75/(commit log)

2026-10-17 Initial commit: Tablo T75 case, design docs, the university app research, service stage 1
    - tablo-cad: printable case model and STLs
    - tablo-presentation: renders and presentation
    - tablo-project.md, tablo-software.md: product and software design
    - research/hseapp: deadline API notes (tokens and captures not tracked)
    - service: protocol, Pillow renderer on demo data, device hub, browser emulator, tests
    [tablo-back.stl, tablo-front.stl, tablo-key_plate.stl, tablo-key_test.stl, tablo-keycap.stl, tablo-keycap_dimple.stl, tablo-leg.stl, tablo.scad]
2026-10-17 Emulator: crisp 1:1 pixels, demo-data switches
    - Emulator scales only by whole numbers; fractional pixelated scaling broke 1-bit text
    - Screen body text uses Inter Medium for sturdier strokes on a 1-bit display
    - Demo switches per block and for the fake HA: GET/PUT /api/demo, saved in data/demo.json,
    checkboxes in the emulator panel; empty blocks show 'no …' placeholders
    - Service closes device sockets on shutdown so Ctrl-C exits at once
2026-10-17 Grades from teachers' Google Sheets (stage 2)
    - sources/grades.py: xlsx export by link, own row by name, header rows only
    (no classmates' data) sent to Claude Haiku for the tab layout, cached by header;
    values normalised to 0-10, bonus kept apart, zero placeholders ignored;
    first fetch is a baseline, later changes become new grades for 7 days
    - store.py: SQLite for layouts, grade items and events
    - llm.py: Haiku with JSON-schema output, imported lazily
    - config.local.yaml (not in git) for personal settings; .env loaded at start
    - Grades block shows a short problem note when sheets or Haiku fail
    - tests on synthetic sheets shaped like the real ones
2026-10-18 Deadlines from the university app (stage 3)
    Keycloak refresh-token login kept in the store, deadlines fetched every
    15 min, short English titles from Haiku checked against the real font,
    "HSE login needed" row and a browser re-login page at /hseapp.
2026-10-18 the university app: update login page, app wiring, source and tests
2026-10-18 Classes from the RUZ timetable (stage 4)
    iCal feed with ETag, shared subject dictionary for classes and deadline
    labels, today-or-next-day rule, Midterm deadlines from interim assessments
    merged with the university app duplicates.
2026-10-18 Docs: stage 5 decisions (timetable only from iCal, first poll reaches 24 h)
2026-10-18 Telegram channels through t.me/s (stage 5)
2026-10-18 News read by Haiku: ranking, replacements, deadlines, column layout (stage 5)
2026-10-18 University mail over IMAP, anonymised letters as fixtures (stage 5)
2026-10-18 News eval: real posts and letters replayed in time order, expected deadlines and importance (stage 5)
2026-10-18 Weather from Open-Meteo and the real Home Assistant over WebSocket: states, buttons, printer line, scripts for long presses (stage 6, §7.4, §7.6, §8.2)
2026-10-18 Config: printer sensors checked
2026-10-18 Home Assistant integration: settings forms, config import, device triggers, tablo.* actions, to-do lists of deadlines, tablo_changed events (stage 7, §6.4, §8)
    Service: GET /api/config, deadline API for the to-do lists (hide, own, edit as own copy), refetch of sources now, panel and HSE login state in /api/status, subjects set by hand in HA.
2026-10-18 Deployment on server: Dockerfile and compose, bridge network on the LAN address, memory measured (stage 8, §12)
2026-10-18 Own API token on the host; device token to change before the first flash (§10)
2026-10-18 Button 1: short press turns all lights on (new script all_lights_on), long press turns them off (§8.2)
    [config.yaml]
2026-10-18 Home block from HA template rows (§8.3)
    home.rows holds up to 5 "label | template" rows. The service subscribes to each template with
    render_template and redraws when HA sends a new result; an empty result or an error hides the row.
    The old sensor, lights and printer fields turn into the same three rows. The integration's Home
    form edits the rows as text and HA checks their syntax on save. The fake HA renders templates
    with jinja2.
    [config.yaml]
2026-10-18 Every Haiku run kept with its task, tokens, cost and duration (§6.6)
    llm_runs in SQLite holds each call, failed ones too; cost from llm.PRICES. The service shows the
    runs in /api/status and GET /api/llm/runs, sends the last one to the panel in health (a "Last LLM"
    line on the diagnostics screen) and tells HA with tablo_changed. The integration adds a sensor per
    task (time of the last run, details as attributes) and "LLM cost today".
2026-10-18 HA integration logo: panel with T and the 8 buttons, icon and logo in light and dark, 1x and 2x, served from brand/
2026-10-21 Data from infomaster: Tablo only shows deadlines, news, grades and classes it serves
    - sources/infomaster.py polls infomaster's internal API every minute (deadlines in screen order, news, grades,
    status) and keeps the last good answers; health.data false after 10 min without one: a status-line icon
    - classes from infomaster's tablo.ics: SUMMARY as is, no Midterm deadlines, cancelled/moved/optional marks in
    place of the room, up to 5 classes
    - per-block problems from infomaster's status; news unavailable after 3 h of failing batches
    - removed: the university app, mail, Telegram channels, news parsing, grades, subject dictionary, own and hidden
    deadlines, merging, Haiku and the LLM diagn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
    [config.yaml]
2026-10-22 infomaster renamed to infomaster
    Source infomaster → infomaster (module, config section, store keys, refresh
    name, HA services and translations), TABLO_UNIMASTER_TOKEN →
    TABLO_INFOMASTER_TOKEN, http://infomaster:8081 and the infomaster docker
    network, X-INFOMASTER-OPTIONAL in the feed. Docs keep the old name in places;
    the mapping is at the top of tablo-software.md.
2026-10-30 Flush keys that sink in when pressed: switches 2 mm deeper, body 15 -> 17 mm, thicker skin over the switch pockets, adapter pad raised to keep the FPC reach
    [tablo-back.stl, tablo-front.stl, tablo-key_test.stl, tablo.scad]
2026-10-30 Firmware skeleton: frames from the service, clock, date and status bar drawn on the board
    - firmware/: PlatformIO, GxEPD2 driver for GDEY075T7 on ESP32-L + DESPI-C02 (CS 27, DC 14, RST 12, BUSY 13)
    - Wi-Fi, WebSocket to the service with backoff, hello/status/frame_ack, config and health, TBLF frames with CRC,
    overlays with ttl, OTA; secrets in include/secrets.h (not in git, example alongside)
    - frame composed row by row: base frame, then clock and status zones; partial refresh of the changed bytes'
    box, full refresh at full_refresh.at, after max_partials and on a big change (over 30 % of 8-pixel cells)
    - the service's pixel fonts and MDI status icons as C tables (tools/gen_assets.py)
    - a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
2026-10-30 Display RST on GPIO26: on GPIO12 the panel held the strap pin high, the board set 1.8 V flash and boot-looped; heap in the connect log
2026-10-30 Back cover exported rotated, not mirrored: the printed cover was a mirror image with the board clips and adapter pad on the wrong side
    [tablo-back.stl, tablo.scad]
2026-10-30 Buttons on the board: 8 keys polled in their own task with debounce and press times, instant tile marks, button 8 full refresh and a diagnostics screen; font chip and flash kept off the bus so MISO c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
2026-10-31 Network in its own task and frames into buffers taken at start: on bad Wi-Fi the link no longer holds up the panel and buttons, and a 48 KB frame no longer fails for lack of a heap block; button 1 mo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
    [buttons.cpp, link.cpp, link.h, main.cpp, screen.cpp, screen.h]
2026-10-31 Optional classes marked with a smiley instead of the word; a full refresh turns the whole screen black, then white, then draws the frame: the driver's fast full update alone left traces on black areas
2026-10-31 Sticky messages: tablo.show_message with sticky stays on the panel until a button, queued oldest first and kept across restarts and reconnects, with a black title bar, the time sent and 1 of N; a dis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
2026-10-31 Printed mushroom pegs for the desk leg instead of screws: the stem is glued into the bar's pilot hole and the shoulder sets the cap 2.8 mm proud, so small-head screws no longer slip out of the keyhol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
    [tablo-peg.stl, tablo.scad]
2026-10-31 Firmware fw-0.4: the shown image moved to IRAM, 408 of 480 rows, read and written as words and handed to the panel driver in 16-row bands; the ordinary heap had 18 KB after start and a few KB once co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
    [link.cpp, main.cpp, screen.cpp, state.h, zones.cpp, zones.h]
2026-10-31 OTA waits 10 s for each piece instead of 1: a Wi-Fi stall or a frame coming in over the WebSocket broke an upload off with error 3
    [main.cpp]
2026-10-31 Firmware fw-0.5: during an OTA update the link lets go and the panel says Updating firmware, a failed update says why and restarts after 10 s; FW_NOTES goes out in hello, and after a new version numb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
    [link.cpp, link.h, main.cpp, screen.cpp, screen.h, state.h]
2026-10-31 Docs brought up to date on 31.10: status at stage 9 with the live panel on fw-0.5, firmware flashing by USB and over the air, the board's serial log, heap and FW_NOTES rules, sticky messages in the R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
2026-10-31 Dark theme, on by default: frames stay 1 = black and the board inverts everything it sends to the panel, its own clock, status, diagnostics and update screens included; theme dark or light comes in c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
    [config.yaml, link.cpp]
2026-10-31 After a new firmware number the welcome goes out before the base frame: the panel keeps a base that comes during an overlay for later, so the welcome no longer waits for a refresh of a frame no one s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
2026-10-31 Firmware fw-0.7: updates over the air go through the service, PUT /api/firmware keeps the image and sends ota, the board downloads /firmware.bin itself in one TCP stream with a bare GET (HTTPClient c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
    [link.cpp, main.cpp, screen.cpp, screen.h]
2026-10-31 CAD: wall mount part
    [tablo-wall_mount.stl, tablo.scad]
2026-10-31 Repository layout: design docs under docs/ (index in docs/README.md, product and hardware in docs/hardware.md), tablo-cad/ is cad/, tablo-presentation/ is presentation/
    [tablo-back.stl, tablo-front.stl, tablo-key_plate.stl, tablo-key_test.stl, tablo-keycap.stl, tablo-keycap_dimple.stl, tablo-leg.stl, tablo-peg.stl]
2026-10-31 Docs in English: the software design, the hardware description and the READMEs of the service, the HA integration and the enclosure; host-specific deployment details replaced with placeholders
2026-10-31 Firmware 0.8: Wi-Fi comes back by itself on a weak signal: after 30 s down the board starts the connection over, every 5th time with the radio off and on; it joins the strongest access point at full 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
2026-11-01 Firmware 0.9: a second press before the answer flips the tile back at once, and each new base frame that changes the tile takes one flip back; the service runs toggles of one entity one after another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
    [buttons.cpp, state.h]
2026-11-08 Printer row in Home is always there again: the default template says idle, paused, done, error or off besides the progress and time left while printing; the row is labelled printer
    [config.yaml]
2026-11-08 Custom board: spec and first schematic draft in KiCad
    docs/hardware.md gets a "Custom board (in design)" section: one long
    board under the keys with an ESP32-S3-WROOM-1U-N16R8, a BQ24074
    charger, a TPS63802 buck-boost, a MAX17048 fuel gauge, a 2000 mAh LiPo,
    the GDEY075T7 reference booster and soldered Choc switches; power modes
    A/B/C, the pin map (button 3 on GPIO14, GPIO3 is a strapping pin),
    values checked against the datasheets, and the decision log.
    pcb/ holds the KiCad 10 project: the schematic passes ERC; TPS63802 and
    MAX17048 symbols live in tablo.kicad_sym. The Choc and VSON-HR-10
    footprints are still to be drawn with the layout. tools/gen_schematic.py
    generated the first draft fro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
    [tablo.kicad_sch]
2026-11-09 Custom board: first layout and the enclosure variant for it
    pcb/tablo.kicad_pcb is a 4-layer board, 173.5 x 41.6 mm, outlined from
    cad/tablo.scad: the parts sit on the side facing the cover, the Choc
    switches go in from the other side with their pins up, the screen FPC
    goes back through a slot to its connector, the battery leads solder to
    two pads. It passes DRC except for three connections left to route by
    hand (listed in pcb/README.md).
    New footprints for the Choc switch and the TPS63802 (VSON-HR-10 from
    the datasheet's example layout). tools/gen_board.py places the parts
    from the netlist; tools/route.py is a small grid router (A* with exit
    zones, rip-up and reroute, vias to the planes);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
    [tablo.kicad_pcb, tablo.kicad_sch, tablo.scad]
2026-11-09 Custom board fully routed: Freerouting finishes the layout
    The nets around the FPC connector and every net with tracks on In2 are
    rerouted by Freerouting on F.Cu and B.Cu, so In1 (GND) and In2 (3.3 V)
    are solid planes and no connection is left open. DRC and the schematic
    parity check pass. pcb/tools/freeroute.py does the DSN export, the
    session import and widens the power tracks Freerouting necked down.
    [tablo.kicad_pcb]
2026-11-09 Enclosure: more board posts, a USB-C backstop, STL sets per board
    The custom-board cover gets four more posts along the board's top edge,
    on spots free of parts, and a stop behind the board's far end that takes
    the force of plugging in USB-C. The STLs are now two full sets:
    stl/esp32l/ (the files as before) and stl/custom/ for the custom board.
    The block diagram no longer mentions a JST-PH battery connector: the
    leads are soldered to pads.
    [tablo-back.stl, tablo-front.stl, tablo-key_plate.stl, tablo-key_test.stl, tablo-keycap.stl, tablo-keycap_dimple.stl, tablo-leg.stl, tablo-peg.stl]
2026-11-09 Custom board: order package for any board house or assembler
    pcb/tools/export_fab.sh now builds one archive with Gerbers and drill
    files, a BOM with manufacturer part numbers (pcb/bom-parts.csv),
    pick-and-place, an assembly drawing, the schematic, ODB++, a STEP model,
    the KiCad project and the same for an assembly panel (rails, tabs with
    mouse bites, fiducials, tooling holes) made by tools/order_package.py.
    The board gets three fiducials, 0.3 mm instead of 0.2 mm vias under the
    ESP32 module, and DNP marks on the key switches, battery pads and test
    pads. Parts checked against datasheets: the screen FPC reaches J3 with
    its contacts facing up, so J3 is the top-contact FH12A (same land
    pattern)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
    [bom-parts.csv, tablo.kicad_pcb, tablo.kicad_sch]
